neykovsimeon/psu01_spiDAC_spiADC/docs/2019-07-20.jpg

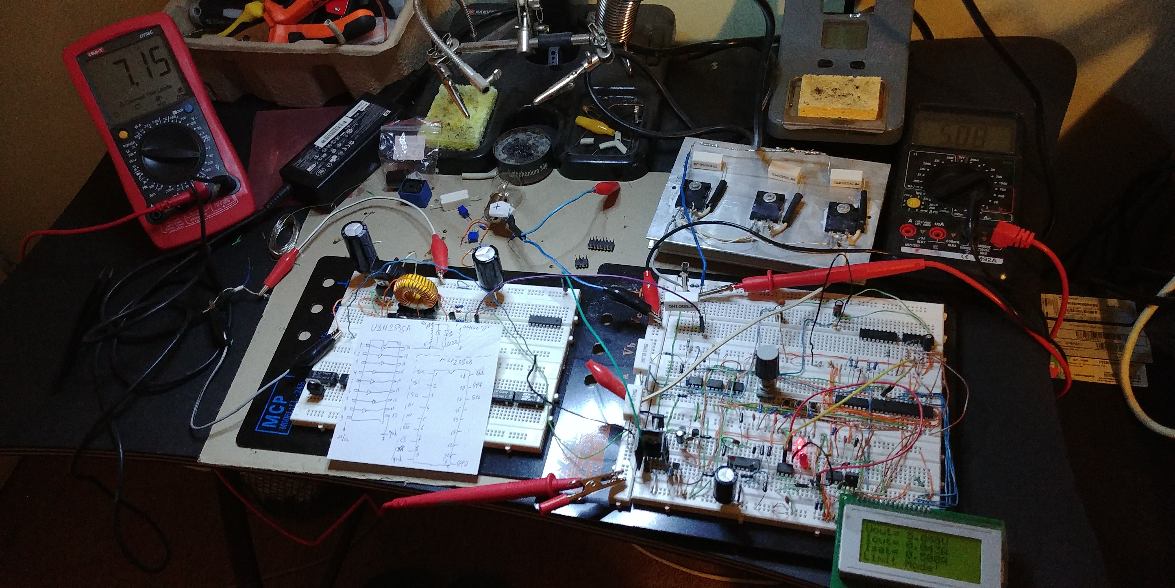
docs/2019-07-20.jpg
