neykovsimeon/psu01_spiDAC_spiADC/LTSpice/PSU_current_sense_low_side_concept_design/PSU1.17_LowSide_CurrentLimit_optoUIreg.pdf

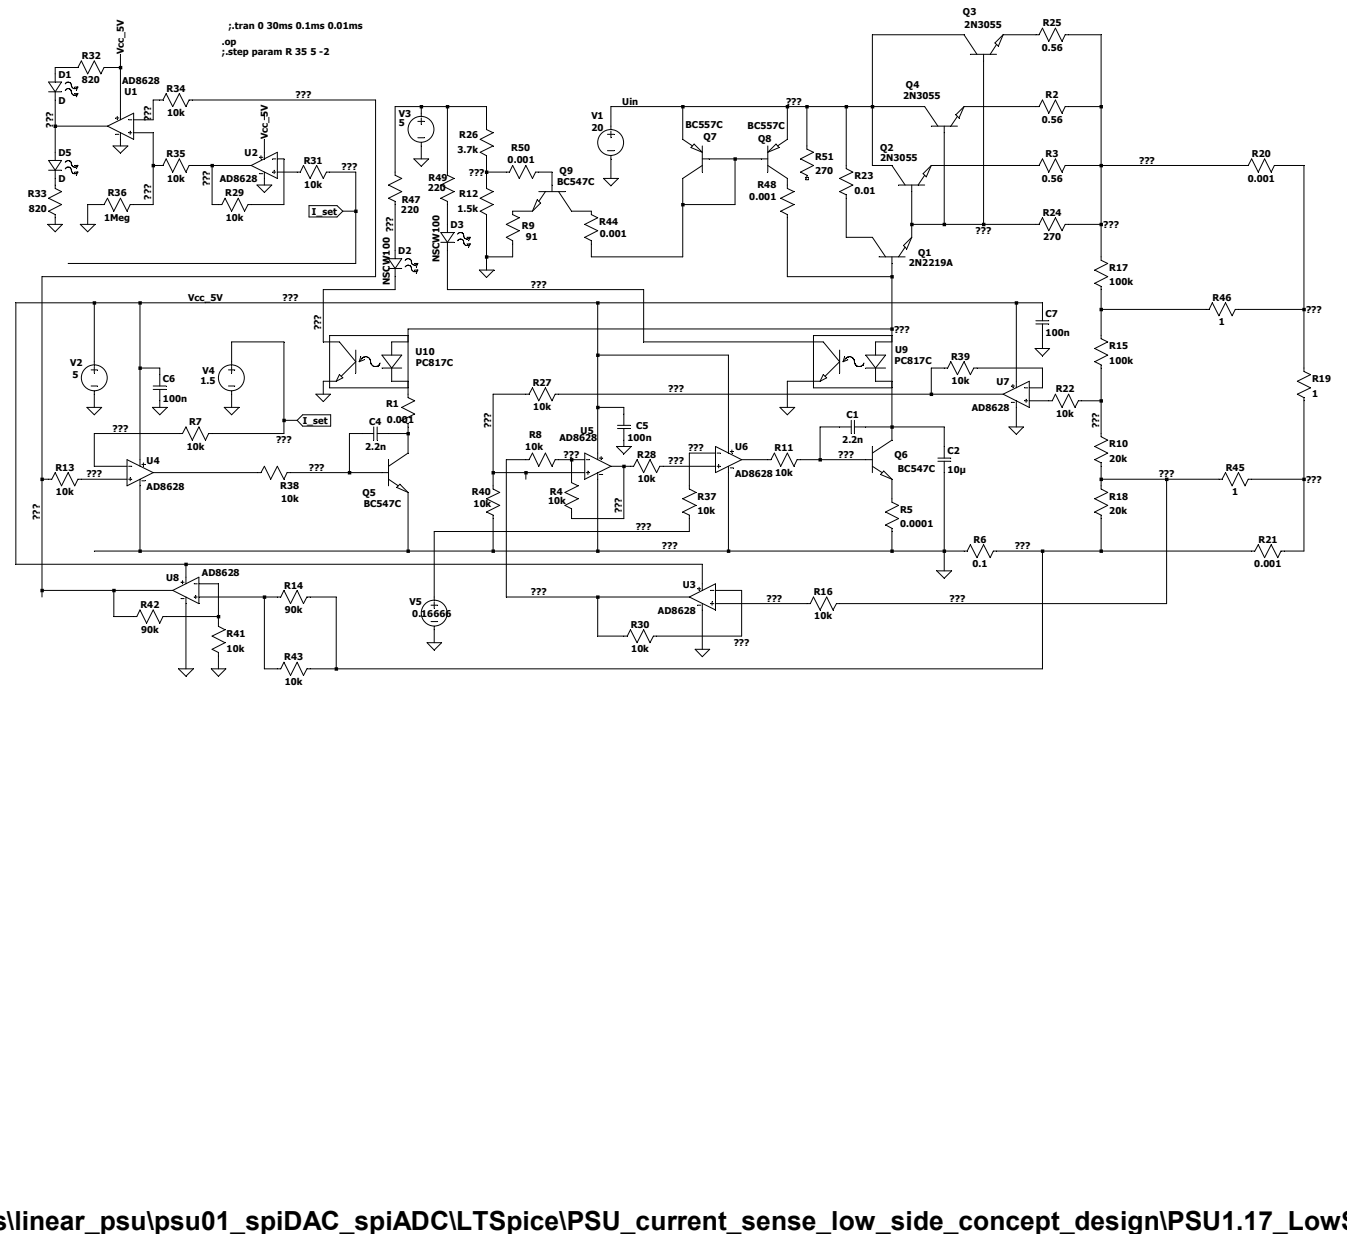
[picture p2: page 1]

--- C:\Users\monka\Desktop\Projects\linear_psu\psu01_spiDAC_spiADC\LTSpice\PSU_current_sense_low_side_concept_design\PSU1.17_LowSide_CurrentLimit_optoUIreg.asc ---
