neykovsimeon/psu01_spiDAC_spiADC/LTSpice/alarm_concept_XNOR.asc

D2: LED; NSPW500BS
D3: LED; NSPW500BS
D4: LED; NSPW500BS
Q1: npn; BC547C
Q2: npn; BC547C
Q3: npn; BC547C
Q4: npn; BC547C
Q5: npn; BC547C
Q6: npn; BC547C
R1: res; 220
R2: res; 220
R3: res; 220
R4: res; 10k
R5: res; 10k
R6: res; 10k
R7: res; 10k
R8: res; 10k
R9: res; 220
R10: res; 220
R11: res; 220
R12: res; 220
R13: res; 10k
R14: res; 220
U1: PC817C
U2: PC817C
V1: voltage; PULSE(0 5 1 0.0001 0.0001 1 2 10)
V2: voltage; 5
V3: voltage; PULSE(5 0 0.5 0.0001 0.0001 1 2 10)
Named nets: 0, Ireg, Ureg, Alarm
;op
.tran 0 10 0.01 0.01
