neykovsimeon/psu01_spiDAC_spiADC/LTSpice/PSU_current_sense_low_side_concept_design/PSU1.17_LowSide_CurrentLimit_optoUIreg.asc

C1: cap; 2.2n; V=50 Irms=130m Rser=1.80898 Lser=0 mfg="KEMET" pn="C0402C222K5RAC" type="X7R"
C2: cap; 10µ; V=25 Irms=9.88 Rser=0.00384339 Lser=0
C3: cap; 100n
C4: cap; 2.2n
C5: cap; 100n
C6: cap; 100n
C7: cap; 100n
C8: cap; 100n
D1: LED
D2: LED; NSCW100
D3: LED; NSCW100
D5: LED
Q1: npn; 2N2219A
Q2: npn; 2N3055
Q3: npn; 2N3055
Q4: npn; 2N3055
Q5: npn; BC547C
Q6: npn; BC547C
Q7: pnp; BC557C
Q8: pnp; BC557C
Q9: npn; BC547C
R1: res; 0.001
R2: res; 0.56; tol=1 pwr=5
R3: res; 0.56; tol=1 pwr=5
R4: res; 10k
R5: res; 0.0001
R6: res; 1
R7: res; 10k
R8: res; 10k
R9: res; 91
R10: res; 20k; pwr=1
R11: res; 10k
R12: res; 1.5k
R13: res; 10k
R14: res; 20k
R15: res; 100k; pwr=1
R16: res; 10k
R17: res; 100k
R18: res; 20k
R19: res; 0.04; pwr=50
R20: res; 1
R21: res; 1
R22: res; 10k
R23: res; 0.01
R24: res; 270; pwr=0.5
R25: res; 0.56; pwr=5
R26: res; 3.7k
R27: res; 10k
R28: res; 10k
R29: res; 10k
R30: res; 10k
R31: res; 10k
R32: res; 820
R33: res; 820
R34: res; 10k
R35: res; 10k
R36: res; 1Meg
R37: res; 10k
R38: res; 10k
R39: res; 10k
R40: res; 10k
R41: res; 10k
R42: res; 20k
R43: res; 10k
R44: res; 0.001
R45: res; 1
R46: res; 1
R47: res; 220
R48: res; 0.001
R49: res; 220
R50: res; 0.001
R51: res; 270
R52: res; 1
R53: res; 1
U1: AD8628
U2: AD8628
U3: AD8628
U4: AD8628
U5: AD8628
U6: AD8628
U7: AD8628
U8: AD8628
U9: PC817C
U10: PC817C
V1: voltage; 8.5
V2: voltage; 12
V3: voltage; 5
V4: voltage; 2.55
V5: voltage; 0.016666
Named nets: 0, Uin, I_set, Vcc_5V, Vout+, Vout-, Vfb, Vfb_sense, Ifb, DRV_BASE
.op
;.step param R 35 5 -2
.tran 0 30ms 0.1ms 0.01ms
