neykovsimeon/psu01_spiDAC_spiADC/LTSpice/2wire4wire_LED.asc

D1: LED; NSPW500BS
D2: LED; NSPW500BS
D3: diode; 1N4148
Q1: npn; BC547C
Q2: npn; BC547C
Q3: pnp; BC557C
R1: res; 220
R2: res; 10k
R3: res; 165
R4: res; 220
R5: res; 7.2k
R6: res; 4.8k
R7: res; 1.5k
R8: res; 7.2k
V1: voltage; 5
V2: voltage; 4.5
Named nets: 0, 4wire, 2wire
.op
Emulate UDN2595A IO driver
Emulate Relay, Rcoil=165ohm
Target:
One IO driver, Active LOW, two LEDs toggle.
Default V2 = HIGH (Relay OFF, LED D1=OFF,  LED D2=ON): 2 Wire output selected
Active V2 = LOW (Relay ON, LED D1=ON, LED D2=OFF): 4 Wire output selected.
