neykovsimeon/psu01_spiDAC_spiADC/HW/psu01_digital.kicad_pcb

## KiCad design HW/psu01_digital.kicad_pcb (2020-02-23)

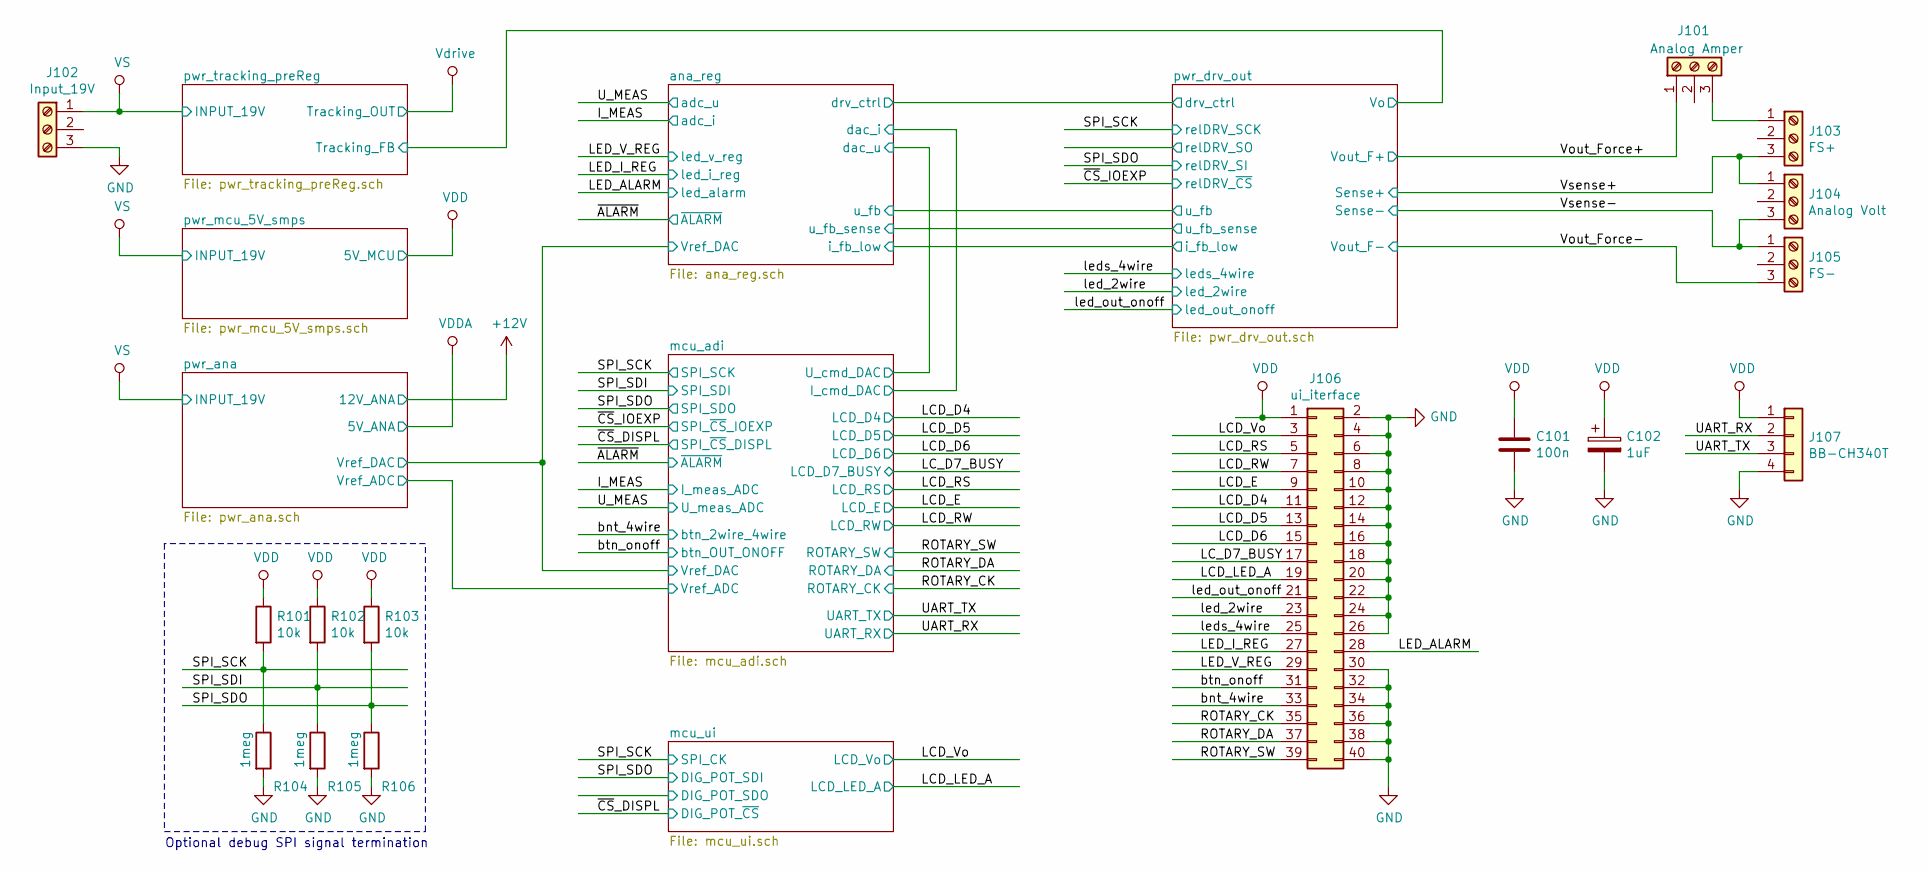
[picture p11: schematic psu01_digital.sch]

Parts:
C101: 100n; C_Axial_L5.1mm_D3.1mm_P7.50mm_Horizontal
C102: 1uF; CP_Radial_D5.0mm_P2.00mm
J101: Analog Amper; TerminalBlock_MetzConnect_Type011_RT05503HBWC_1x03_P5.00mm_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
J102: Input_19V; TerminalBlock_MetzConnect_Type011_RT05503HBWC_1x03_P5.00mm_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
J103: FS+; TerminalBlock_MetzConnect_Type011_RT05503HBWC_1x03_P5.00mm_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
J104: Analog Volt; TerminalBlock_MetzConnect_Type011_RT05503HBWC_1x03_P5.00mm_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
J105: FS-; TerminalBlock_MetzConnect_Type011_RT05503HBWC_1x03_P5.00mm_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
J106: ui_iterface; IDC-Header_2x20_P2.54mm_Vertical
J107: BB-CH340T; FanPinHeader_1x04_P2.54mm_Vertical
R101, R102, R103: 10k; R_Axial_DIN0309_L9.0mm_D3.2mm_P12.70mm_Horizontal
R104, R105, R106: 1meg; R_Axial_DIN0309_L9.0mm_D3.2mm_P12.70mm_Horizontal

Connections:
/LCD_D4: J106.11; also elsewhere on the board
/LCD_D5: J106.13; also elsewhere on the board
/LCD_D6: J106.15; also elsewhere on the board
/LCD_E: J106.9; also elsewhere on the board
/LCD_LED_A: J106.19; also elsewhere on the board
/LCD_RS: J106.5; also elsewhere on the board
/LCD_RW: J106.7; also elsewhere on the board
/LCD_Vo: J106.3; also elsewhere on the board
/LC_D7_BUSY: J106.17; also elsewhere on the board
/LED_ALARM: J106.28; also elsewhere on the board
/LED_I_REG: J106.27; also elsewhere on the board
/LED_V_REG: J106.29; also elsewhere on the board
/ROTARY_CK: J106.35; also elsewhere on the board
/ROTARY_DA: J106.37; also elsewhere on the board
/ROTARY_SW: J106.39; also elsewhere on the board
/SPI_SCK: R101.2, R104.1; also elsewhere on the board
/SPI_SDI: R102.2, R105.1; also elsewhere on the board
/SPI_SDO: R103.2, R106.1; also elsewhere on the board
/UART_RX: J107.2; also elsewhere on the board
/UART_TX: J107.3; also elsewhere on the board
/Vout_Force+: J101.1; also elsewhere on the board
/Vout_Force-: J105.3; also elsewhere on the board
/Vsense+: J103.3, J104.1; also elsewhere on the board
/Vsense-: J104.3, J105.1; also elsewhere on the board
/bnt_4wire: J106.33; also elsewhere on the board
/btn_onoff: J106.31; also elsewhere on the board
/led_2wire: J106.23; also elsewhere on the board
/led_out_onoff: J106.21; also elsewhere on the board
/leds_4wire: J106.25; also elsewhere on the board
GND: C101.2, C102.2, J102.3, J106.2, J106.4, J106.6, J106.8, J106.10, J106.12, J106.14, J106.16, J106.18, J106.20, J106.22, J106.24, J106.26, J106.30, J106.32, J106.34, J106.36, J106.38, J106.40, J107.4, R104.2, R105.2, R106.2; also elsewhere on the board
unnamed: J101.3, J103.1
VDD: C101.1, C102.1, J106.1, J107.1, R101.1, R102.1, R103.1; also elsewhere on the board
VS: J102.1; also elsewhere on the board

Notes on the sheet:
Optional debug SPI signal termination

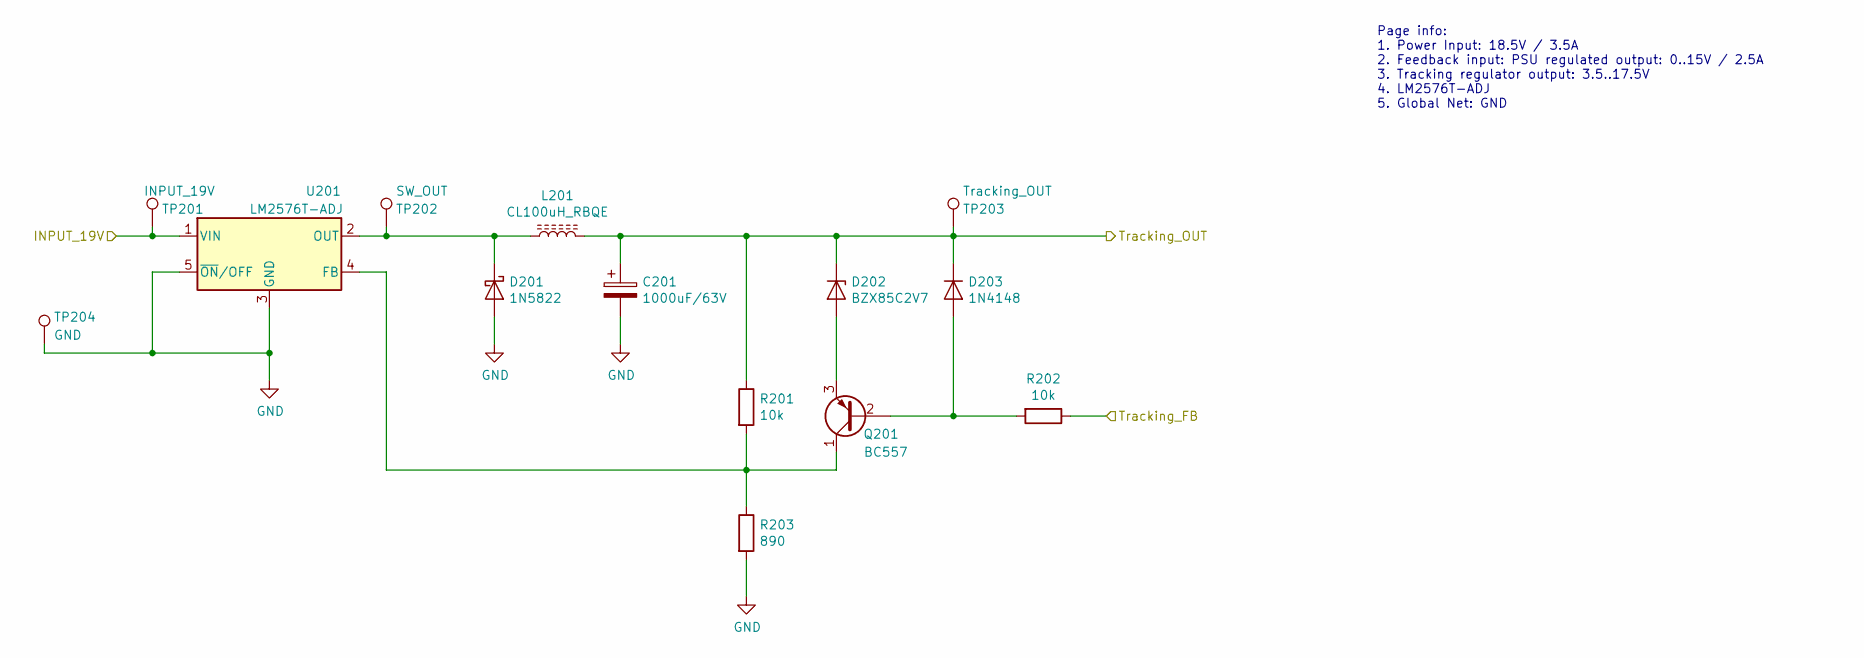
[picture p12: schematic pwr_tracking_preReg.sch]

Parts:
C201: 1000uF/63V; CP_Radial_D18.0mm_P7.50mm
D201: 1N5822; D_DO-201AD_P15.24mm_Horizontal
D202: BZX85C2V7; D_DO-41_SOD81_P12.70mm_Horizontal
D203: 1N4148; D_DO-35_SOD27_P7.62mm_Horizontal
L201: CL100uH_RBQE; L_Toroid_Vertical_L41.9mm_W19.1mm_P15.80mm_Vishay_TJ7
Q201: BC557; TO-92_Inline
R201, R202: 10k; R_Axial_DIN0309_L9.0mm_D3.2mm_P12.70mm_Horizontal
R203: 890; R_Axial_DIN0309_L9.0mm_D3.2mm_P12.70mm_Horizontal
TP201: INPUT_19V; TestPoint_Loop_D2.50mm_Drill1.0mm
TP202: SW_OUT; TestPoint_Loop_D2.50mm_Drill1.0mm
TP203: Tracking_OUT; TestPoint_Loop_D2.50mm_Drill1.0mm
TP204: GND; TestPoint_Loop_D2.50mm_Drill1.0mm
U201: LM2576T-ADJ; TO-220-5_Vertical

Connections:
/pwr_tracking_preReg/Tracking_FB: R202.1; also elsewhere on the board
GND: C201.2, D201.2 (A), R203.2, TP204.1, U201.3 (GND), U201.5 (~ON~/OFF); also elsewhere on the board
unnamed: D201.1 (K), L201.1, TP202.1, U201.2 (OUT)
unnamed: D202.2 (A), Q201.3 (E)
unnamed: D203.2 (A), Q201.2 (B), R202.2
unnamed: Q201.1 (C), R201.2, R203.1, U201.4 (FB)
VS: TP201.1, U201.1 (VIN); also elsewhere on the board
Vdrive: C201.1, D202.1 (K), D203.1 (K), L201.2, R201.1, TP203.1; also elsewhere on the board

Notes on the sheet:
Page info: 1. Power Input: 18.5V / 3.5A 2. Feedback input: PSU regulated output: 0..15V / 2.5A 3. Tracking regulator output: 3.5..17.5V 4. LM2576T-ADJ 5. Global Net: GND

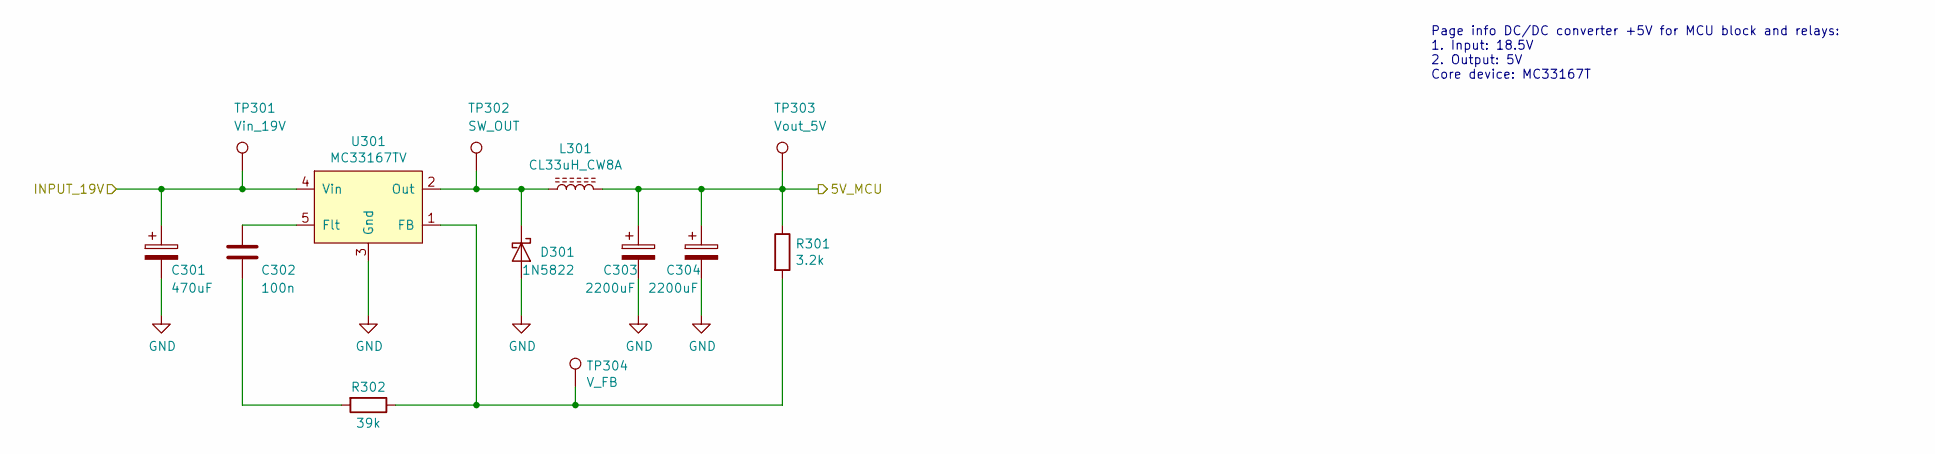
[picture p13: schematic pwr_mcu_5V_smps.sch]

Parts:
C301: 470uF; CP_Radial_D13.0mm_P5.00mm
C302: 100n; C_Axial_L5.1mm_D3.1mm_P7.50mm_Horizontal
C303, C304: 2200uF; CP_Radial_D18.0mm_P7.50mm
D301: 1N5822; D_DO-201AD_P15.24mm_Horizontal
L301: CL33uH_CW8A; L_Radial_D10.0mm_P5.00mm_Fastron_07M
R301: 3.2k; R_Axial_DIN0309_L9.0mm_D3.2mm_P12.70mm_Horizontal
R302: 39k; R_Axial_DIN0309_L9.0mm_D3.2mm_P12.70mm_Horizontal
TP301: Vin_19V; TestPoint_Loop_D2.50mm_Drill1.0mm
TP302: SW_OUT; TestPoint_Loop_D2.50mm_Drill1.0mm
TP303: Vout_5V; TestPoint_Loop_D2.50mm_Drill1.0mm
TP304: V_FB; TestPoint_Loop_D2.50mm_Drill1.0mm
U301: MC33167TV; TO-220-5_P3.4x3.7mm_StaggerOdd_Lead3.8mm_Vertical

Connections:
GND: C301.2, C303.2, C304.2, D301.2 (A), U301.3 (Gnd); also elsewhere on the board
unnamed: C302.1, U301.5 (Flt)
unnamed: C302.2, R302.2
unnamed: D301.1 (K), L301.1, TP302.1, U301.2 (Out)
unnamed: R301.2, R302.1, TP304.1, U301.1 (FB)
VDD: C303.1, C304.1, L301.2, R301.1, TP303.1; also elsewhere on the board
VS: C301.1, TP301.1, U301.4 (Vin); also elsewhere on the board

Notes on the sheet:
Page info DC/DC converter +5V for MCU block and relays: 1. Input: 18.5V 2. Output: 5V Core device: MC33167T

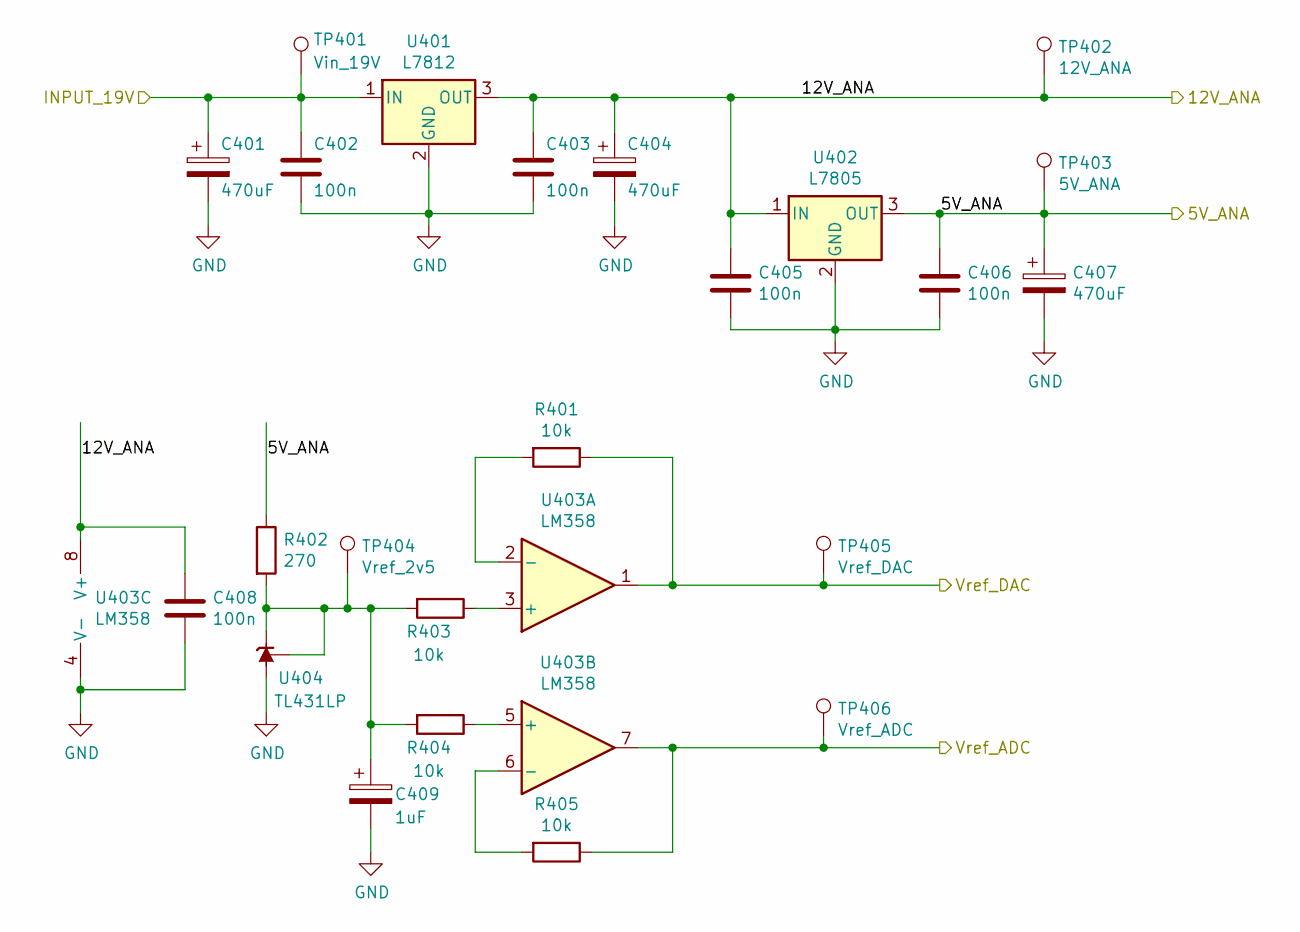
[picture p14: schematic pwr_ana.sch]

Parts:
C401, C404, C407: 470uF; CP_Radial_D13.0mm_P5.00mm
C402, C403, C405, C406, C408: 100n; C_Axial_L5.1mm_D3.1mm_P7.50mm_Horizontal
C409: 1uF; CP_Radial_D5.0mm_P2.50mm
R401, R403, R404, R405: 10k; R_Axial_DIN0309_L9.0mm_D3.2mm_P12.70mm_Horizontal
R402: 270; R_Axial_DIN0309_L9.0mm_D3.2mm_P12.70mm_Horizontal
TP401: Vin_19V; TestPoint_Loop_D2.50mm_Drill1.0mm
TP402: 12V_ANA; TestPoint_Loop_D2.50mm_Drill1.0mm
TP403: 5V_ANA; TestPoint_Loop_D2.50mm_Drill1.0mm
TP404: Vref_2v5; TestPoint_Loop_D2.50mm_Drill1.0mm
TP405: Vref_DAC; TestPoint_Loop_D2.50mm_Drill1.0mm
TP406: Vref_ADC; TestPoint_Loop_D2.50mm_Drill1.0mm
U401: L7812; TO-220-3_Vertical
U402: L7805; TO-220-3_Vertical
U403: LM358; DIP-8_W7.62mm_Socket_LongPads
U404: TL431LP; TO-92_Inline

Connections:
+12V: C403.1, C404.1, C405.1, C408.1, TP402.1, U401.3 (OUT), U402.1 (IN), U403.8 (V+); also elsewhere on the board
/ana_reg/Vref_DAC: R401.1, TP405.1, U403.1; also elsewhere on the board
/mcu_adi/Vref_ADC: R405.1, TP406.1, U403.7; also elsewhere on the board
GND: C401.2, C402.2, C403.2, C404.2, C405.2, C406.2, C407.2, C408.2, C409.2, U401.2 (GND), U402.2 (GND), U403.4 (V-), U404.2 (A); also elsewhere on the board
unnamed: C409.1, R402.2, R403.2, R404.2, TP404.1, U404.1 (REF), U404.3 (K)
unnamed: R401.2, U403.2 (-)
unnamed: R403.1, U403.3 (+)
unnamed: R404.1, U403.5 (+)
unnamed: R405.2, U403.6 (-)
VDDA: C406.1, C407.1, R402.1, TP403.1, U402.3 (OUT); also elsewhere on the board
VS: C401.1, C402.1, TP401.1, U401.1 (IN); also elsewhere on the board

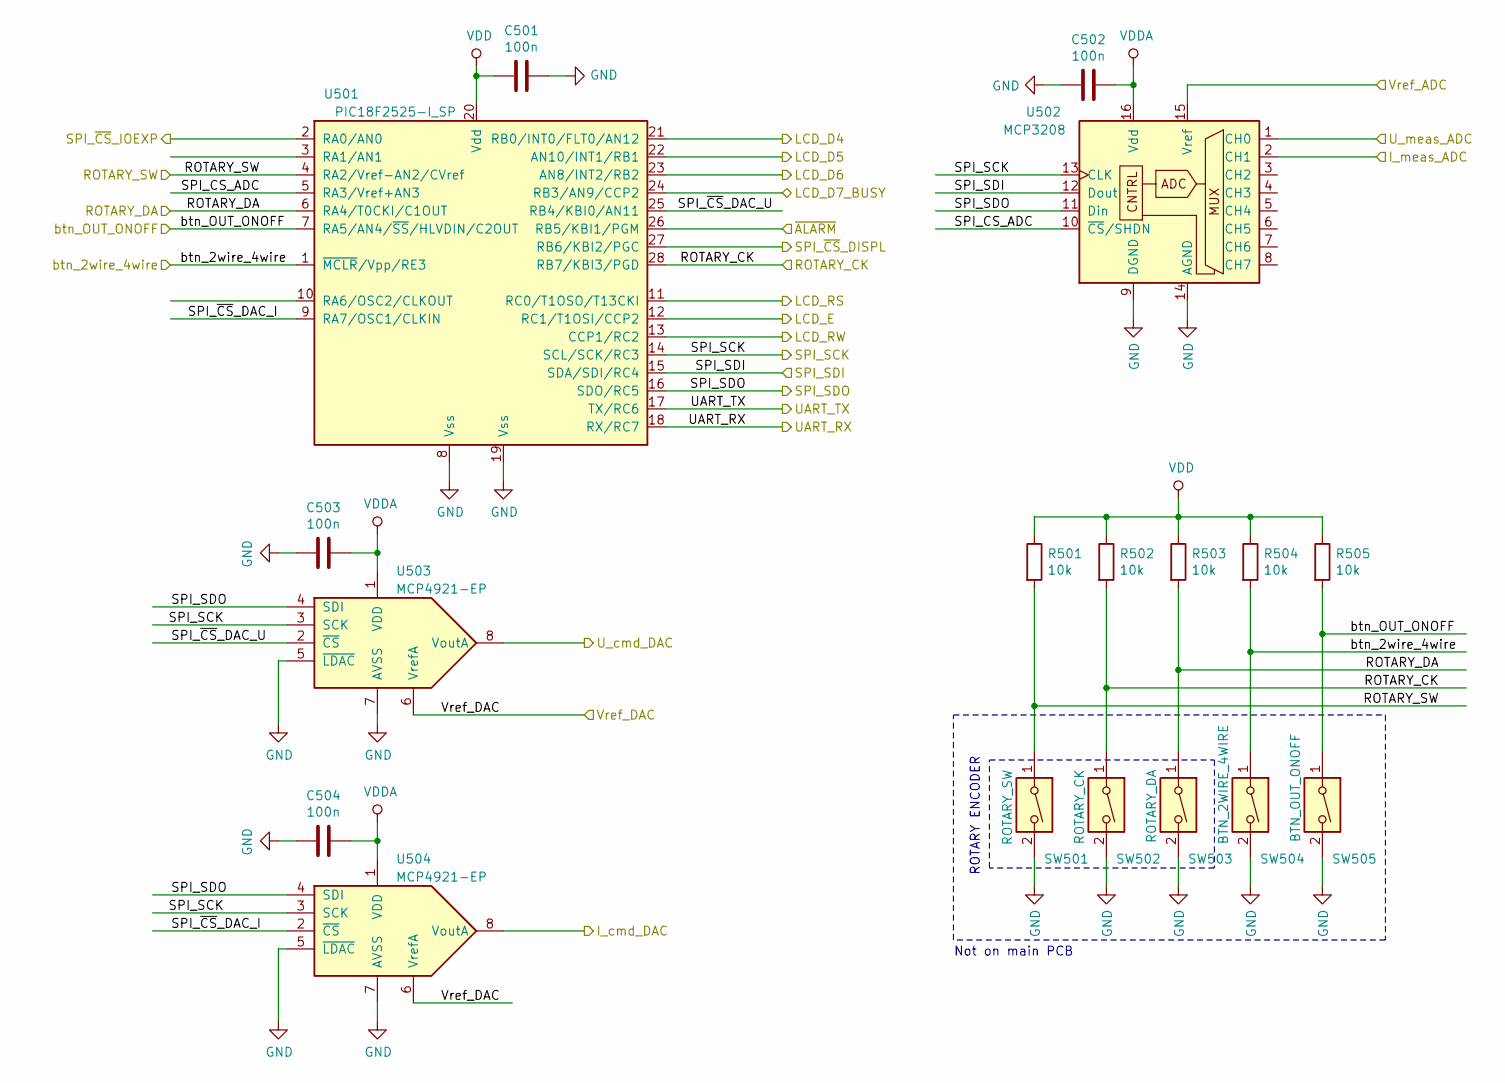
[picture p15: schematic mcu_adi.sch]

Parts:
C501, C502, C503, C504: 100n; C_Axial_L5.1mm_D3.1mm_P7.50mm_Horizontal
R501, R502, R503, R504, R505: 10k; R_Axial_DIN0309_L9.0mm_D3.2mm_P12.70mm_Horizontal
SW501: ROTARY_SW; TerminalBlock_MetzConnect_Type059_RT06302HBWC_1x02_P3.50mm_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
SW502: ROTARY_CK; TerminalBlock_MetzConnect_Type059_RT06302HBWC_1x02_P3.50mm_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
SW503: ROTARY_DA; TerminalBlock_MetzConnect_Type059_RT06302HBWC_1x02_P3.50mm_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
SW504: BTN_2WIRE_4WIRE; TerminalBlock_MetzConnect_Type059_RT06302HBWC_1x02_P3.50mm_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
SW505: BTN_OUT_ONOFF; TerminalBlock_MetzConnect_Type059_RT06302HBWC_1x02_P3.50mm_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
U501: PIC18F2525-I_SP; DIP-28_W7.62mm_Socket_LongPads
U502: MCP3208; DIP-16_W7.62mm_Socket_LongPads
U503, U504: MCP4921-EP; DIP-8_W7.62mm_Socket_LongPads

Connections:
/I_MEAS: U502.2 (CH1); also elsewhere on the board
/LCD_D4: U501.21 (RB0/INT0/FLT0/AN12); also elsewhere on the board
/LCD_D5: U501.22 (AN10/INT1/RB1); also elsewhere on the board
/LCD_D6: U501.23 (AN8/INT2/RB2); also elsewhere on the board
/LCD_E: U501.12 (RC1/T1OSI/CCP2); also elsewhere on the board
/LCD_RS: U501.11 (RC0/T1OSO/T13CKI); also elsewhere on the board
/LCD_RW: U501.13 (CCP1/RC2); also elsewhere on the board
/LC_D7_BUSY: U501.24 (RB3/AN9/CCP2); also elsewhere on the board
/ROTARY_CK: R502.2, SW502.1, U501.28 (RB7/KBI3/PGD); also elsewhere on the board
/ROTARY_DA: R503.2, SW503.1, U501.6 (RA4/T0CKI/C1OUT); also elsewhere on the board
/ROTARY_SW: R501.2, SW501.1, U501.4 (RA2/Vref-AN2/CVref); also elsewhere on the board
/SPI_SCK: U501.14 (SCL/SCK/RC3), U502.13 (CLK), U503.3 (SCK), U504.3 (SCK); also elsewhere on the board
/SPI_SDI: U501.15 (SDA/SDI/RC4), U502.12 (Dout); also elsewhere on the board
/SPI_SDO: U501.16 (SDO/RC5), U502.11 (Din), U503.4 (SDI), U504.4 (SDI); also elsewhere on the board
/UART_RX: U501.18 (RX/RC7); also elsewhere on the board
/UART_TX: U501.17 (TX/RC6); also elsewhere on the board
/U_MEAS: U502.1 (CH0); also elsewhere on the board
/ana_reg/Vref_DAC: U503.6 (VrefA), U504.6 (VrefA); also elsewhere on the board
/bnt_4wire: R504.2, SW504.1, U501.1 (~MCLR~/Vpp/RE3); also elsewhere on the board
/btn_onoff: R505.2, SW505.1, U501.7 (RA5/AN4/~SS~/HLVDIN/C2OUT); also elsewhere on the board
/mcu_adi/I_cmd_DAC: U504.8 (VoutA); also elsewhere on the board
/mcu_adi/SPI_CS_ADC: U501.5 (RA3/Vref+AN3), U502.10 (~CS~/SHDN)
/mcu_adi/SPI_~CS~_DAC_I: U501.9 (RA7/OSC1/CLKIN), U504.2 (~CS~)
/mcu_adi/SPI_~CS~_DAC_U: U501.25 (RB4/KBI0/AN11), U503.2 (~CS~)
/mcu_adi/U_cmd_DAC: U503.8 (VoutA); also elsewhere on the board
/mcu_adi/Vref_ADC: U502.15 (Vref); also elsewhere on the board
/~ALARM: U501.26 (RB5/KBI1/PGM); also elsewhere on the board
/~CS~_DISPL: U501.27 (RB6/KBI2/PGC); also elsewhere on the board
/~CS~_IOEXP: U501.2 (RA0/AN0); also elsewhere on the board
GND: C501.1, C502.2, C503.2, C504.2, SW501.2, SW502.2, SW503.2, SW504.2, SW505.2, U501.8 (Vss), U501.19 (Vss), U502.9 (DGND), U502.14 (AGND), U503.5 (~LDAC~), U503.7 (AVSS), U504.5 (~LDAC~), U504.7 (AVSS); also elsewhere on the board
VDD: C501.2, R501.1, R502.1, R503.1, R504.1, R505.1, U501.20 (Vdd); also elsewhere on the board
VDDA: C502.1, C503.1, C504.1, U502.16 (Vdd), U503.1 (VDD), U504.1 (VDD); also elsewhere on the board

Notes on the sheet:
ROTARY ENCODER
Not on main PCB

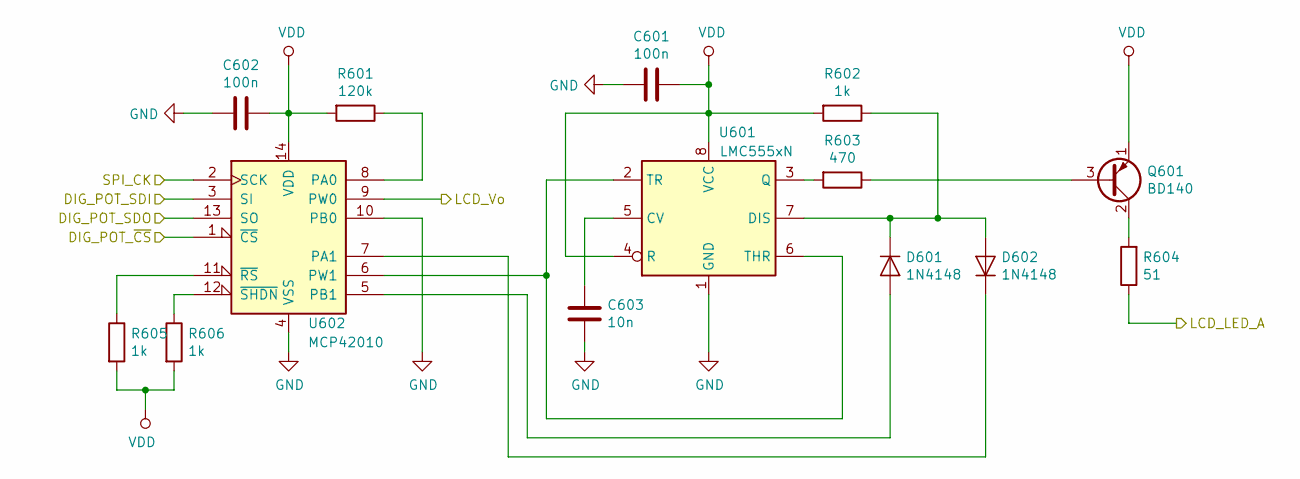
[picture p16: schematic mcu_ui.sch]

Parts:
C601, C602: 100n; C_Axial_L5.1mm_D3.1mm_P7.50mm_Horizontal
C603: 10n; C_Axial_L5.1mm_D3.1mm_P7.50mm_Horizontal
D601, D602: 1N4148; D_DO-35_SOD27_P7.62mm_Horizontal
Q601: BD140; TO-126-3_Vertical
R601: 120k; R_Axial_DIN0309_L9.0mm_D3.2mm_P12.70mm_Horizontal
R602, R605, R606: 1k; R_Axial_DIN0309_L9.0mm_D3.2mm_P12.70mm_Horizontal
R603: 470; R_Axial_DIN0309_L9.0mm_D3.2mm_P12.70mm_Horizontal
R604: 51; R_Axial_DIN0309_L9.0mm_D3.2mm_P12.70mm_Horizontal
U601: LMC555xN; DIP-8_W7.62mm_Socket_LongPads
U602: MCP42010; DIP-14_W7.62mm_Socket_LongPads

Connections:
/LCD_LED_A: R604.1; also elsewhere on the board
/LCD_Vo: U602.9 (PW0); also elsewhere on the board
/SPI_SCK: U602.2 (SCK); also elsewhere on the board
/SPI_SDO: U602.3 (SI); also elsewhere on the board
/mcu_ui/DIG_POT_SDO: U602.13 (SO)
/~CS~_DISPL: U602.1 (~CS); also elsewhere on the board
GND: C601.2, C602.2, C603.1, U601.1 (GND), U602.4 (VSS), U602.10 (PB0); also elsewhere on the board
unnamed: C603.2, U601.5 (CV)
unnamed: D601.1 (K), D602.2 (A), R602.1, U601.7 (DIS)
unnamed: D601.2 (A), U602.5 (PB1)
unnamed: D602.1 (K), U602.7 (PA1)
unnamed: Q601.2 (C), R604.2
unnamed: Q601.3 (B), R603.1
unnamed: R601.1, U602.8 (PA0)
unnamed: R603.2, U601.3 (Q)
unnamed: R605.1, U602.11 (~RS)
unnamed: R606.1, U602.12 (~SHDN)
unnamed: U601.2 (TR), U601.6 (THR), U602.6 (PW1)
VDD: C601.1, C602.1, Q601.1 (E), R601.2, R602.2, R605.2, R606.2, U601.4 (R), U601.8 (VCC), U602.14 (VDD); also elsewhere on the board

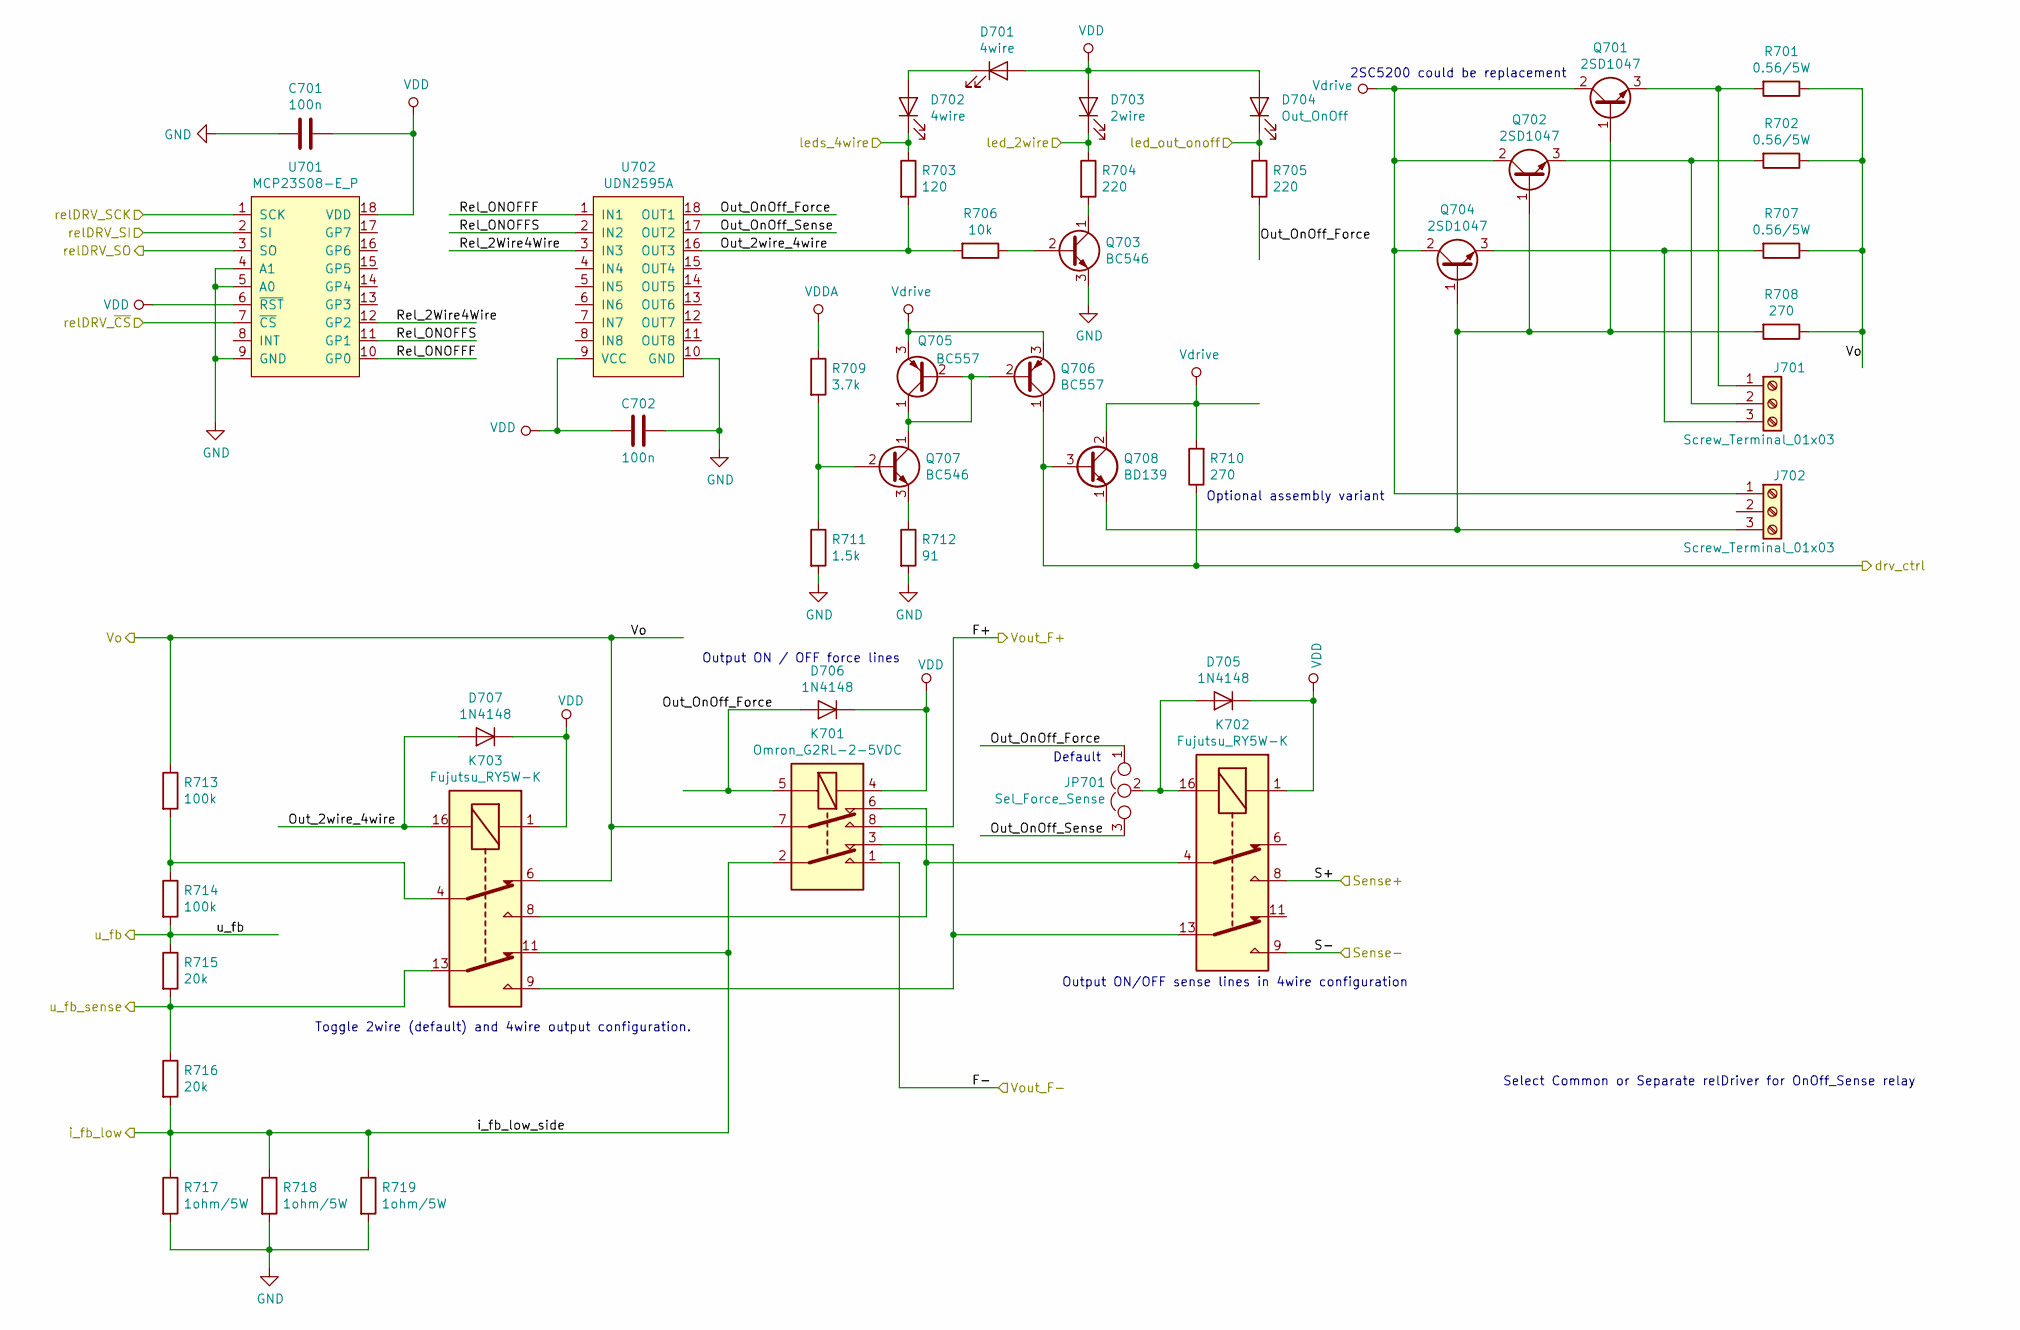
[picture p17: schematic pwr_drv_out.sch, PSU1.0_Power_Driver_Out]

Parts:
C701, C702: 100n; C_Axial_L5.1mm_D3.1mm_P7.50mm_Horizontal
D701, D702: 4wire; TerminalBlock_MetzConnect_Type059_RT06302HBWC_1x02_P3.50mm_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
D703: 2wire; TerminalBlock_MetzConnect_Type059_RT06302HBWC_1x02_P3.50mm_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
D704: Out_OnOff; TerminalBlock_MetzConnect_Type059_RT06302HBWC_1x02_P3.50mm_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
D705, D706, D707: 1N4148; D_DO-35_SOD27_P7.62mm_Horizontal
J701, J702: Screw_Terminal_01x03; TerminalBlock_MetzConnect_Type011_RT05503HBWC_1x03_P5.00mm_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
JP701: Sel_Force_Sense; PinHeader_1x03_P2.54mm_Vertical
K701: Omron_G2RL-2-5VDC; Relay_DPDT_Fujitsu_FTR-F1C
K702, K703: Fujutsu_RY5W-K; Relay_DPDT_Omron_G5V-2
Q701, Q702, Q704: 2SD1047; TO-3PB-3_Vertical
Q703, Q707: BC546; TO-92_Inline
Q705, Q706: BC557; TO-92_Inline
Q708: BD139; TO-126-3_Vertical
R701, R702, R707: 0.56/5W; R_Axial_DIN0918_L18.0mm_D9.0mm_P25.40mm_Horizontal
R703: 120; R_Axial_DIN0309_L9.0mm_D3.2mm_P12.70mm_Horizontal
R704, R705: 220; R_Axial_DIN0309_L9.0mm_D3.2mm_P12.70mm_Horizontal
R706: 10k; R_Axial_DIN0309_L9.0mm_D3.2mm_P12.70mm_Horizontal
R708, R710: 270; R_Axial_DIN0309_L9.0mm_D3.2mm_P12.70mm_Horizontal
R709: 3.7k; R_Axial_DIN0309_L9.0mm_D3.2mm_P12.70mm_Horizontal
R711: 1.5k; R_Axial_DIN0309_L9.0mm_D3.2mm_P12.70mm_Horizontal
R712: 91; R_Axial_DIN0309_L9.0mm_D3.2mm_P12.70mm_Horizontal
R713, R714: 100k; R_Axial_DIN0309_L9.0mm_D3.2mm_P12.70mm_Horizontal
R715, R716: 20k; R_Axial_DIN0309_L9.0mm_D3.2mm_P12.70mm_Horizontal
R717, R718, R719: 1ohm/5W; R_Axial_DIN0918_L18.0mm_D9.0mm_P25.40mm_Horizontal
U701: MCP23S08-E_P; DIP-18_W7.62mm_Socket_LongPads
U702: UDN2595A; DIP-18_W7.62mm_Socket_LongPads

Connections:
/SPI_SCK: U701.1 (SCK); also elsewhere on the board
/SPI_SDO: U701.2 (SI); also elsewhere on the board
/Vout_Force+: K701.8; also elsewhere on the board
/Vout_Force-: K701.1; also elsewhere on the board
/Vsense+: K702.8; also elsewhere on the board
/Vsense-: K702.9; also elsewhere on the board
/ana_reg/drv_ctrl: Q706.1 (C), Q708.3 (B), R710.1; also elsewhere on the board
/ana_reg/i_fb_low: K701.2, K703.11, R716.2, R717.1, R718.1, R719.1; also elsewhere on the board
/ana_reg/u_fb: R714.2, R715.1; also elsewhere on the board
/ana_reg/u_fb_sense: K703.13, R715.2, R716.1; also elsewhere on the board
/led_2wire: D703.1 (K), R704.1; also elsewhere on the board
/led_out_onoff: D704.1 (K), R705.1; also elsewhere on the board
/leds_4wire: D702.1 (K), R703.1; also elsewhere on the board
/pwr_drv_out/Out_2wire_4wire: D707.2 (A), K703.16, R703.2, R706.2, U702.16 (OUT3)
/pwr_drv_out/Out_OnOff_Force: D706.2 (A), JP701.1, K701.5, R705.2, U702.18 (OUT1)
/pwr_drv_out/Out_OnOff_Sense: JP701.3, U702.17 (OUT2)
/pwr_drv_out/Rel_2Wire4Wire: U701.12 (GP2), U702.3 (IN3)
/pwr_drv_out/Rel_ONOFFF: U701.10 (GP0), U702.1 (IN1)
/pwr_drv_out/Rel_ONOFFS: U701.11 (GP1), U702.2 (IN2)
/pwr_drv_out/relDRV_SO: U701.3 (SO)
/pwr_tracking_preReg/Tracking_FB: K701.7, K703.6, R701.1, R702.1, R707.1, R708.1, R713.1; also elsewhere on the board
/~CS~_IOEXP: U701.7 (~CS); also elsewhere on the board
GND: C701.2, C702.1, Q703.3 (E), R711.2, R712.2, R717.2, R718.2, R719.2, U701.4 (A1), U701.5 (A0), U701.9 (GND), U702.10 (GND); also elsewhere on the board
unnamed: D701.1 (K), D702.2 (A)
unnamed: D705.2 (A), JP701.2, K702.16
unnamed: J701.1, Q701.3 (E), R701.2
unnamed: J701.2, Q702.3 (E), R702.2
unnamed: J701.3, Q704.3 (E), R707.2
unnamed: J702.3, Q701.1 (B), Q702.1 (B), Q704.1 (B), Q708.1 (E), R708.2
unnamed: K701.3, K702.13, K703.9
unnamed: K701.6, K702.4, K703.8
unnamed: K703.4, R713.2, R714.1
unnamed: Q703.1 (C), R704.2
unnamed: Q703.2 (B), R706.1
unnamed: Q705.1 (C), Q705.2 (B), Q706.2 (B), Q707.1 (C)
unnamed: Q707.2 (B), R709.2, R711.1
unnamed: Q707.3 (E), R712.1
VDD: C701.1, C702.2, D701.2 (A), D703.2 (A), D704.2 (A), D705.1 (K), D706.1 (K), D707.1 (K), K701.4, K702.1, K703.1, U701.6 (~RST), U701.18 (VDD), U702.9 (VCC); also elsewhere on the board
VDDA: R709.1; also elsewhere on the board
Vdrive: J702.1, Q701.2 (C), Q702.2 (C), Q704.2 (C), Q705.3 (E), Q706.3 (E), Q708.2 (C), R710.2; also elsewhere on the board

Notes on the sheet:
Default
Select Common or Separate relDriver for OnOff_Sense relay
Toggle 2wire (default) and 4wire output configuration.
Output ON / OFF force lines
Output ON/OFF sense lines in 4wire configuration
Optional assembly variant
2SC5200 could be replacement
