neykovsimeon/psu01_spiDAC_spiADC/HW/psu01_digital.kicad_pcb

## KiCad design HW/psu01_digital.kicad_pcb (continued)

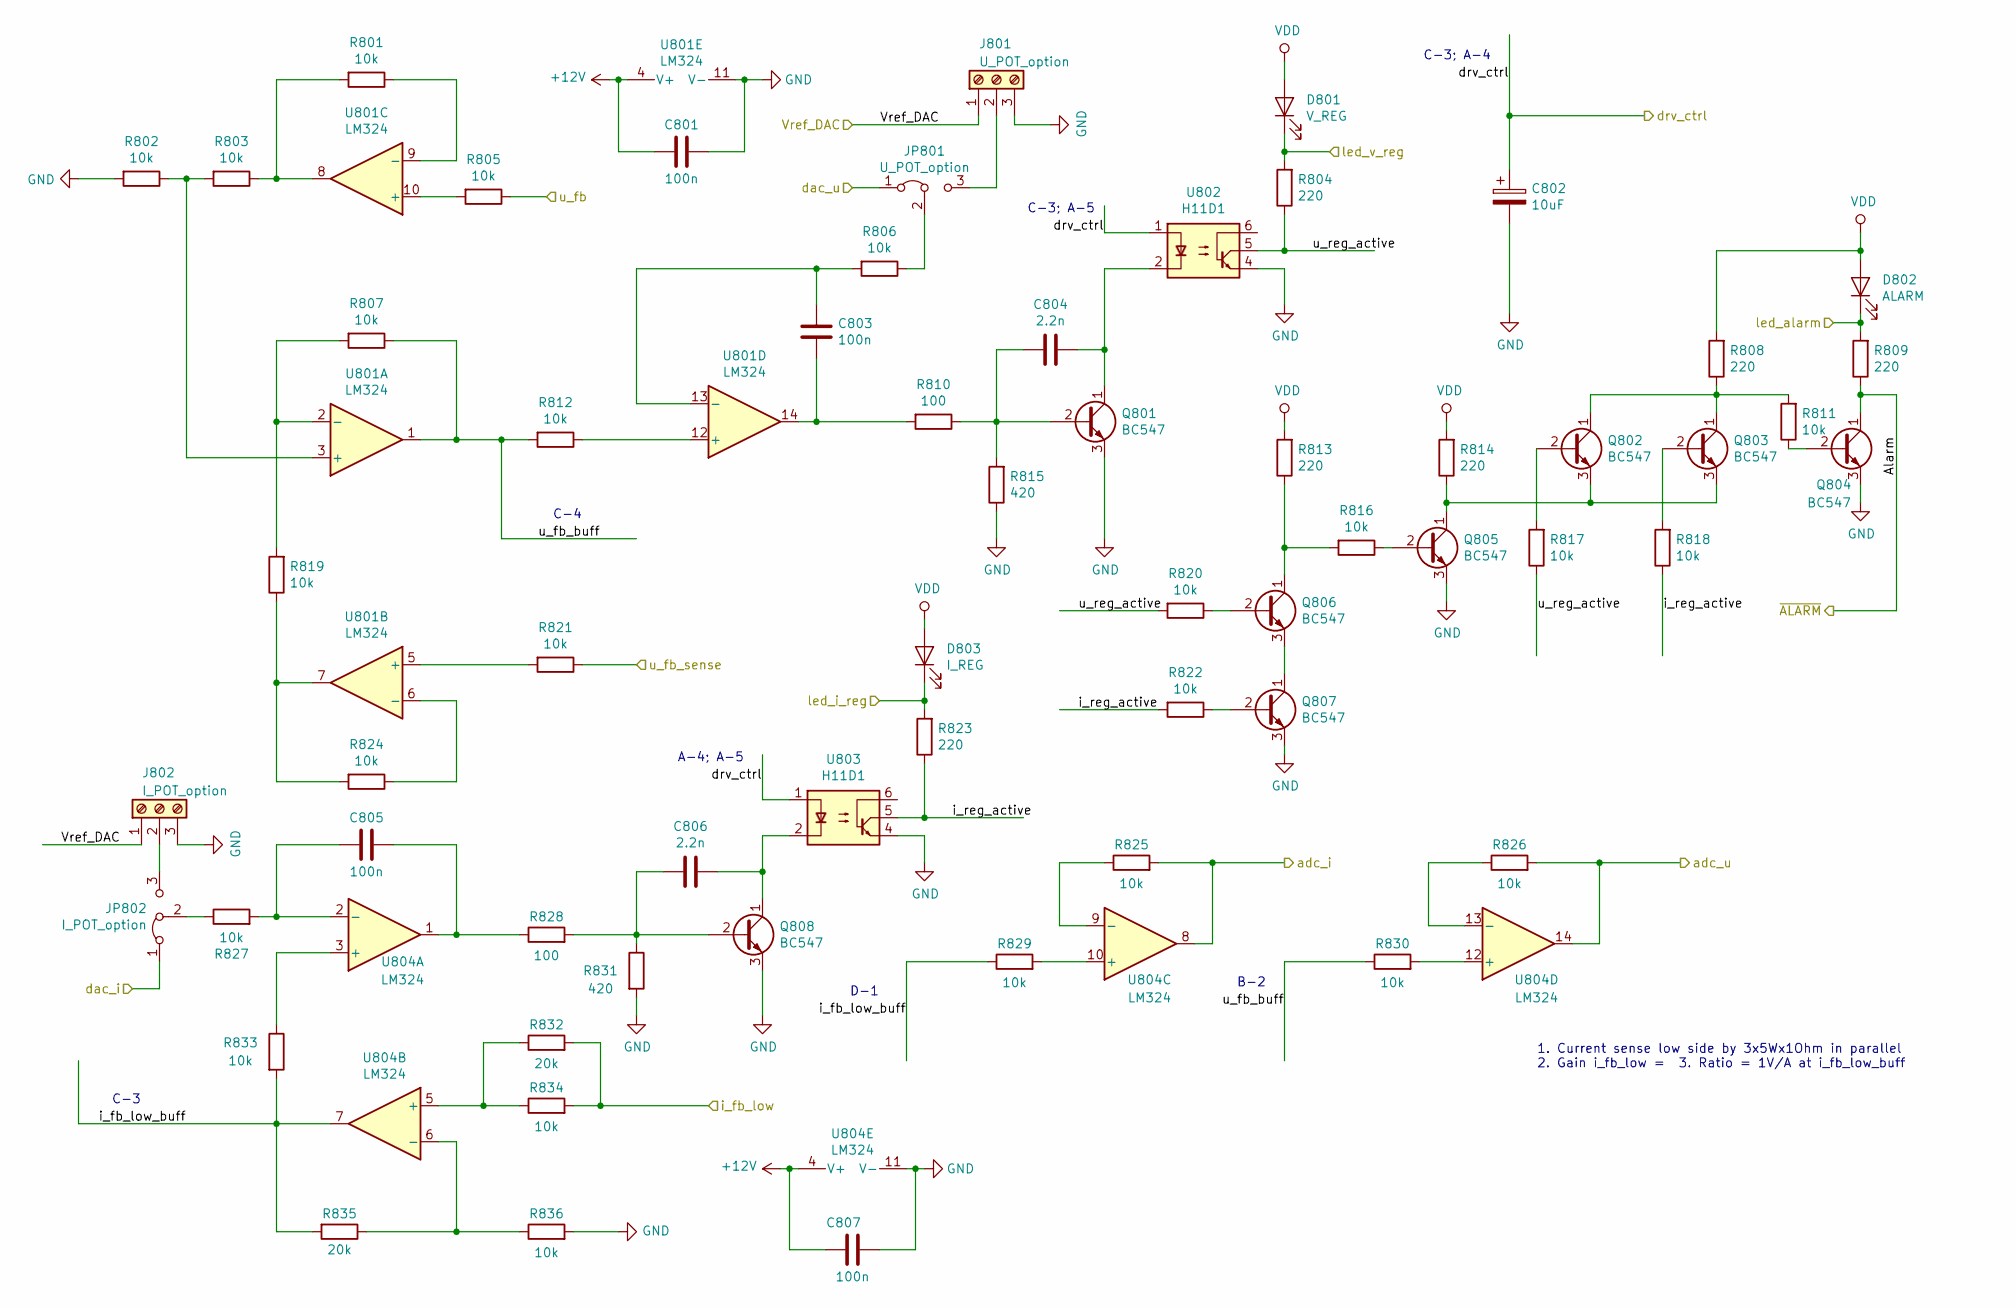
[picture p18: schematic ana_reg.sch, PSU1.0_Analog_Voltage_Current_Regulators]

Parts:
C801, C803, C805, C807: 100n; C_Axial_L5.1mm_D3.1mm_P7.50mm_Horizontal
C802: 10uF; CP_Radial_D5.0mm_P2.00mm
C804, C806: 2.2n; C_Axial_L5.1mm_D3.1mm_P7.50mm_Horizontal
D801: V_REG; TerminalBlock_MetzConnect_Type059_RT06302HBWC_1x02_P3.50mm_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
D802: ALARM; TerminalBlock_MetzConnect_Type059_RT06302HBWC_1x02_P3.50mm_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
D803: I_REG; TerminalBlock_MetzConnect_Type059_RT06302HBWC_1x02_P3.50mm_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
J801: U_POT_option; TerminalBlock_MetzConnect_Type011_RT05503HBWC_1x03_P5.00mm_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
J802: I_POT_option; TerminalBlock_MetzConnect_Type011_RT05503HBWC_1x03_P5.00mm_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
JP801: U_POT_option; PinHeader_1x03_P2.54mm_Vertical
JP802: I_POT_option; PinHeader_1x03_P2.54mm_Vertical
Q801, Q802, Q803, Q804, Q805, Q806, Q807, Q808: BC547; TO-92_Inline
R801, R802, R803, R805, R806, R807, R811, R812, R816, R817, R818, R819, R820, R821, R822, R824, R825, R826, R827, R829, R830, R833, R834, R836: 10k; R_Axial_DIN0309_L9.0mm_D3.2mm_P12.70mm_Horizontal
R804, R808, R809, R813, R814, R823: 220; R_Axial_DIN0309_L9.0mm_D3.2mm_P12.70mm_Horizontal
R810, R828: 100; R_Axial_DIN0309_L9.0mm_D3.2mm_P12.70mm_Horizontal
R815, R831: 420; R_Axial_DIN0309_L9.0mm_D3.2mm_P12.70mm_Horizontal
R832, R835: 20k; R_Axial_DIN0309_L9.0mm_D3.2mm_P12.70mm_Horizontal
U801: LM324; DIP-14_W7.62mm_Socket_LongPads
U802, U803: H11D1; DIP-6_W7.62mm_Socket_LongPads
U804: LM324

Connections:
+12V: C801.2, C807.2, U801.4 (V+), U804.4 (V+); also elsewhere on the board
/I_MEAS: R825.2, U804.8; also elsewhere on the board
/LED_ALARM: D802.1 (K), R809.2; also elsewhere on the board
/LED_I_REG: D803.1 (K), R823.2; also elsewhere on the board
/LED_V_REG: D801.1 (K), R804.2; also elsewhere on the board
/U_MEAS: R826.2, U804.14; also elsewhere on the board
/ana_reg/Vref_DAC: J801.1, J802.1; also elsewhere on the board
/ana_reg/drv_ctrl: C802.1, U802.1, U803.1; also elsewhere on the board
/ana_reg/i_fb_low: R832.2, R834.2; also elsewhere on the board
/ana_reg/i_fb_low_buff: R829.1, R833.2, R835.2, U804.7
/ana_reg/i_reg_active: R818.1, R822.2, R823.1, U803.5
/ana_reg/u_fb: R805.1; also elsewhere on the board
/ana_reg/u_fb_buff: R807.1, R812.2, R830.1, U801.1
/ana_reg/u_fb_sense: R821.1; also elsewhere on the board
/ana_reg/u_reg_active: R804.1, R817.1, R820.2, U802.5
/mcu_adi/I_cmd_DAC: JP802.1 (A); also elsewhere on the board
/mcu_adi/U_cmd_DAC: JP801.1 (A); also elsewhere on the board
/~ALARM: Q804.1 (C), R809.1; also elsewhere on the board
GND: C801.1, C802.2, C807.1, J801.3, J802.3, Q801.3 (E), Q804.3 (E), Q805.3 (E), Q807.3 (E), Q808.3 (E), R802.2, R815.1, R831.2, R836.2, U801.11 (V-), U802.4, U803.4, U804.11 (V-); also elsewhere on the board
unnamed: C803.1, R806.2, U801.13 (-)
unnamed: C803.2, R810.2, U801.14
unnamed: C804.1, Q801.1 (C), U802.2
unnamed: C804.2, Q801.2 (B), R810.1, R815.2
unnamed: C805.1, R828.1, U804.1
unnamed: C805.2, R827.2, U804.2 (-)
unnamed: C806.1, Q808.1 (C), U803.2
unnamed: C806.2, Q808.2 (B), R828.2, R831.1
unnamed: J801.2, JP801.3 (B)
unnamed: J802.2, JP802.3 (B)
unnamed: JP801.2 (C), R806.1
unnamed: JP802.2 (C), R827.1
unnamed: Q802.1 (C), Q803.1 (C), R808.1, R811.2
unnamed: Q802.2 (B), R817.2
unnamed: Q802.3 (E), Q803.3 (E), Q805.1 (C), R814.1
unnamed: Q803.2 (B), R818.2
unnamed: Q804.2 (B), R811.1
unnamed: Q805.2 (B), R816.1
unnamed: Q806.1 (C), R813.1, R816.2
unnamed: Q806.2 (B), R820.1
unnamed: Q806.3 (E), Q807.1 (C)
unnamed: Q807.2 (B), R822.1
unnamed: R801.1, U801.9 (-)
unnamed: R801.2, R803.1, U801.8
unnamed: R802.1, R803.2, U801.3 (+)
unnamed: R805.2, U801.10 (+)
unnamed: R807.2, R819.2, U801.2 (-)
unnamed: R812.1, U801.12 (+)
unnamed: R819.1, R824.2, U801.7
unnamed: R821.2, U801.5 (+)
unnamed: R824.1, U801.6 (-)
unnamed: R825.1, U804.9 (-)
unnamed: R826.1, U804.13 (-)
unnamed: R829.2, U804.10 (+)
unnamed: R830.2, U804.12 (+)
unnamed: R832.1, R834.1, U804.5 (+)
unnamed: R833.1, U804.3 (+)
unnamed: R835.1, R836.1, U804.6 (-)
VDD: D801.2 (A), D802.2 (A), D803.2 (A), R808.2, R813.2, R814.2; also elsewhere on the board

Notes on the sheet:
1. Current sense low side by 3x5Wx1Ohm in parallel 2. Gain i_fb_low = 3. Ratio = 1V/A at i_fb_low_buff
C-3
D-1
C-3; A-5
C-3; A-4
A-4; A-5
B-2
C-4

Board: 2 copper layers, 204 parts (0 on the bottom side), 139 nets, no tracks yet.
