neykovsimeon/psu01_spiDAC_spiADC/psu01_spiADC.X/display_functions.h

/* 
 * File:   display_functions.h
 * Author: PC
 *
 * Created on 02 Dec 2018, 14:24
 */

#ifndef DISPLAY_FUNCTIONS_H
#define	DISPLAY_FUNCTIONS_H

void default_display (void);
void contrast_display (void);
void brightness_display (void);
void voltage_set_display (void);
void current_protection_set_display (void);
void current_limit_set_display (void);
void current_auto_limit_set_display (void);
void protection_display (void);
void warning_display_ONOFF (void);
void warning_display_4wires (void);
void show_on_screen (unsigned char screen_mode);

#endif	/* DISPLAY_FUNCTIONS_H */
