neykovsimeon/psu01_spiDAC_spiADC/psu01_spiADC.X/pushButtons.h

/* 
 * File:   pushButtons.h
 * Author: PC
 *
 * Created on 02 Dec 2018, 15:31
 */

#ifndef PUSHBUTTONS_H
#define	PUSHBUTTONS_H

//void pushButtons_display_settings(void);
void pushButtons_relDriver();

#endif	/* PUSHBUTTONS_H */
