neykovsimeon/psu01_spiDAC_spiADC/(commit log)

2019-07-20 Initial commit, PCU_Rev001, spi dac, spi adc, mcu menu, rotary encoder
2019-08-18 Rev004 - added MCP23S08 spi driver, added output ON/OFF and 2 wire / 4 wire configs
2020-02-23 Initial HW
    [ana_I_reg.sch, ana_I_sense.sch, ana_U_reg.sch, ana_reg.sch, mcu_adi.sch, mcu_ui.sch, psu01_digital.kicad_pcb, psu01_digital.sch]
